MIT-STARLab/PorTeL-Beacon/PorTeL_beacon_board.pdf

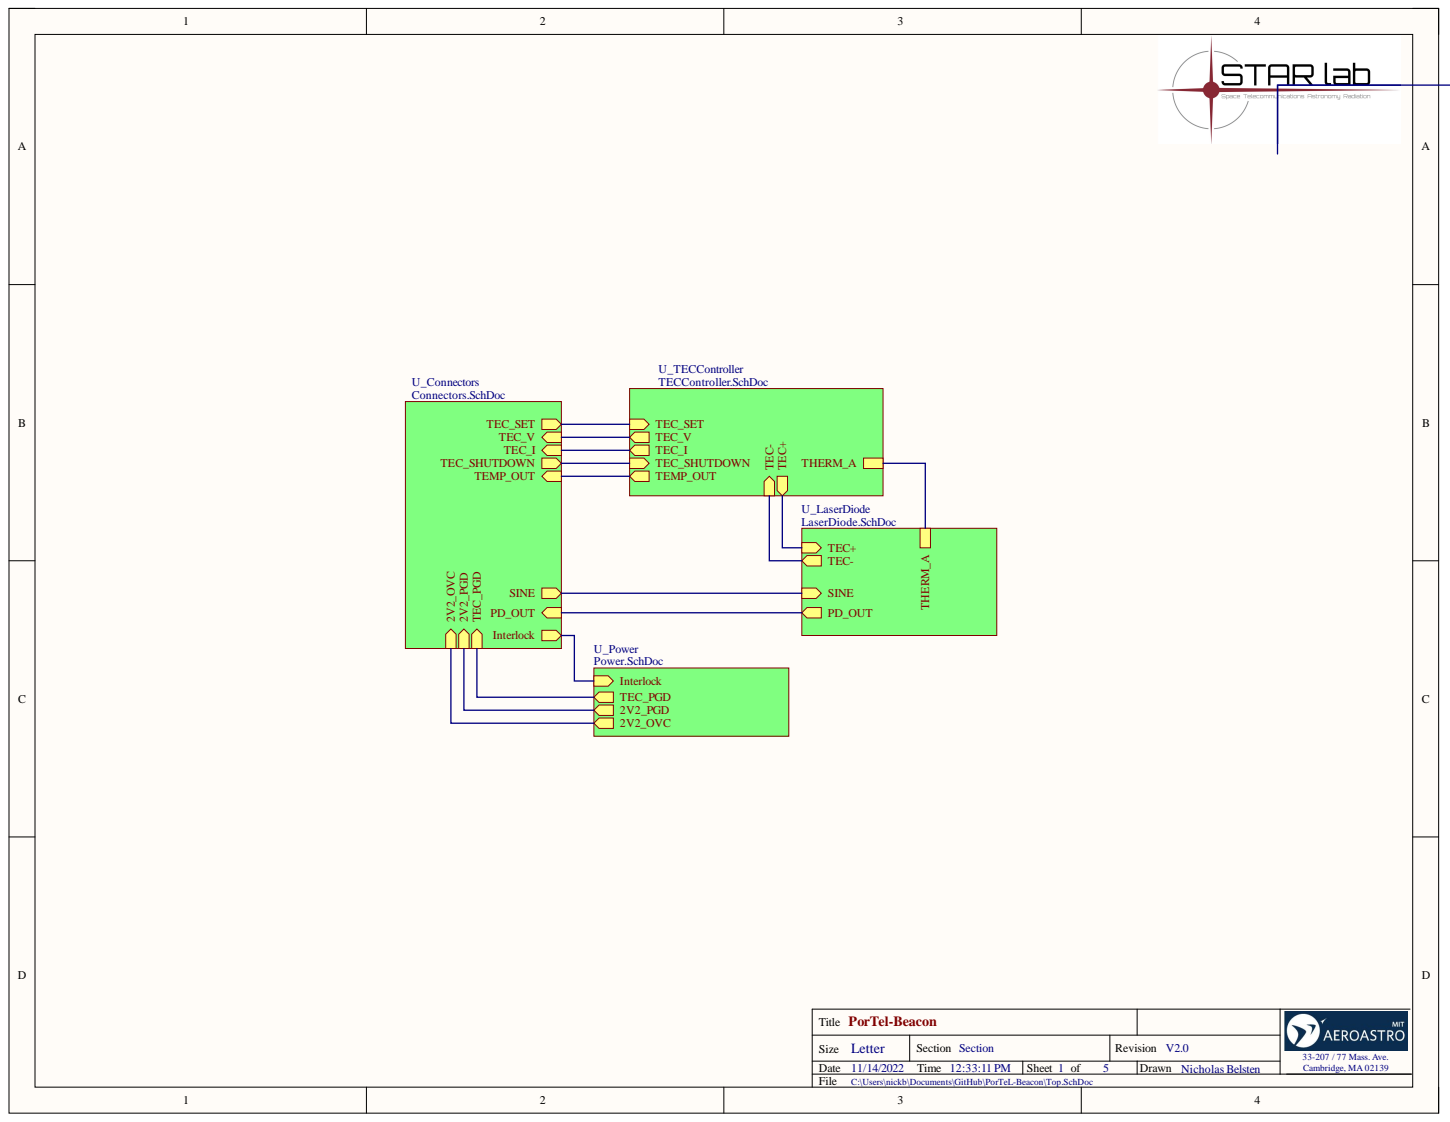
[picture p1: page 1]

C:\Users\nickb\Documents\GitHub\PorTeL-Beacon\Top.SchDoc

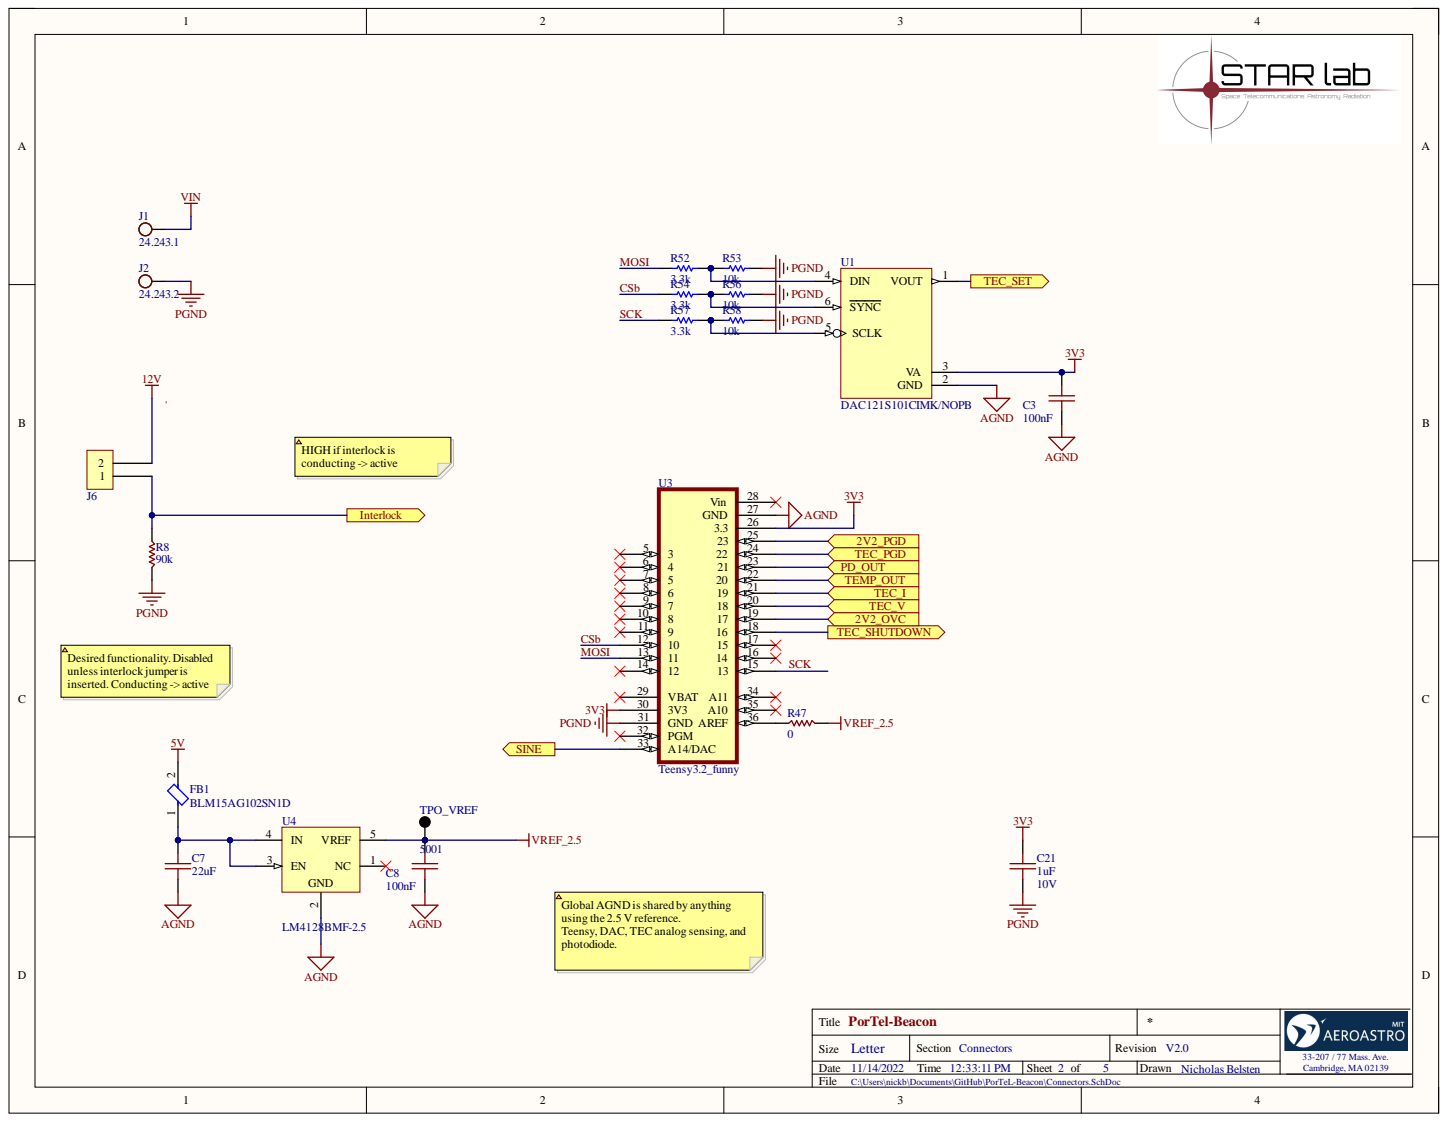
[picture p2: page 2]

HIGH if interlock is
conducting -> active

Global AGND isshared by anything
using the 2.5 V reference.
Teensy, DAC, TEC analog sensing, and
photodiode.

C:\Users\nickb\Documents\GitHub\PorTeL-Beacon\Connectors.SchDoc

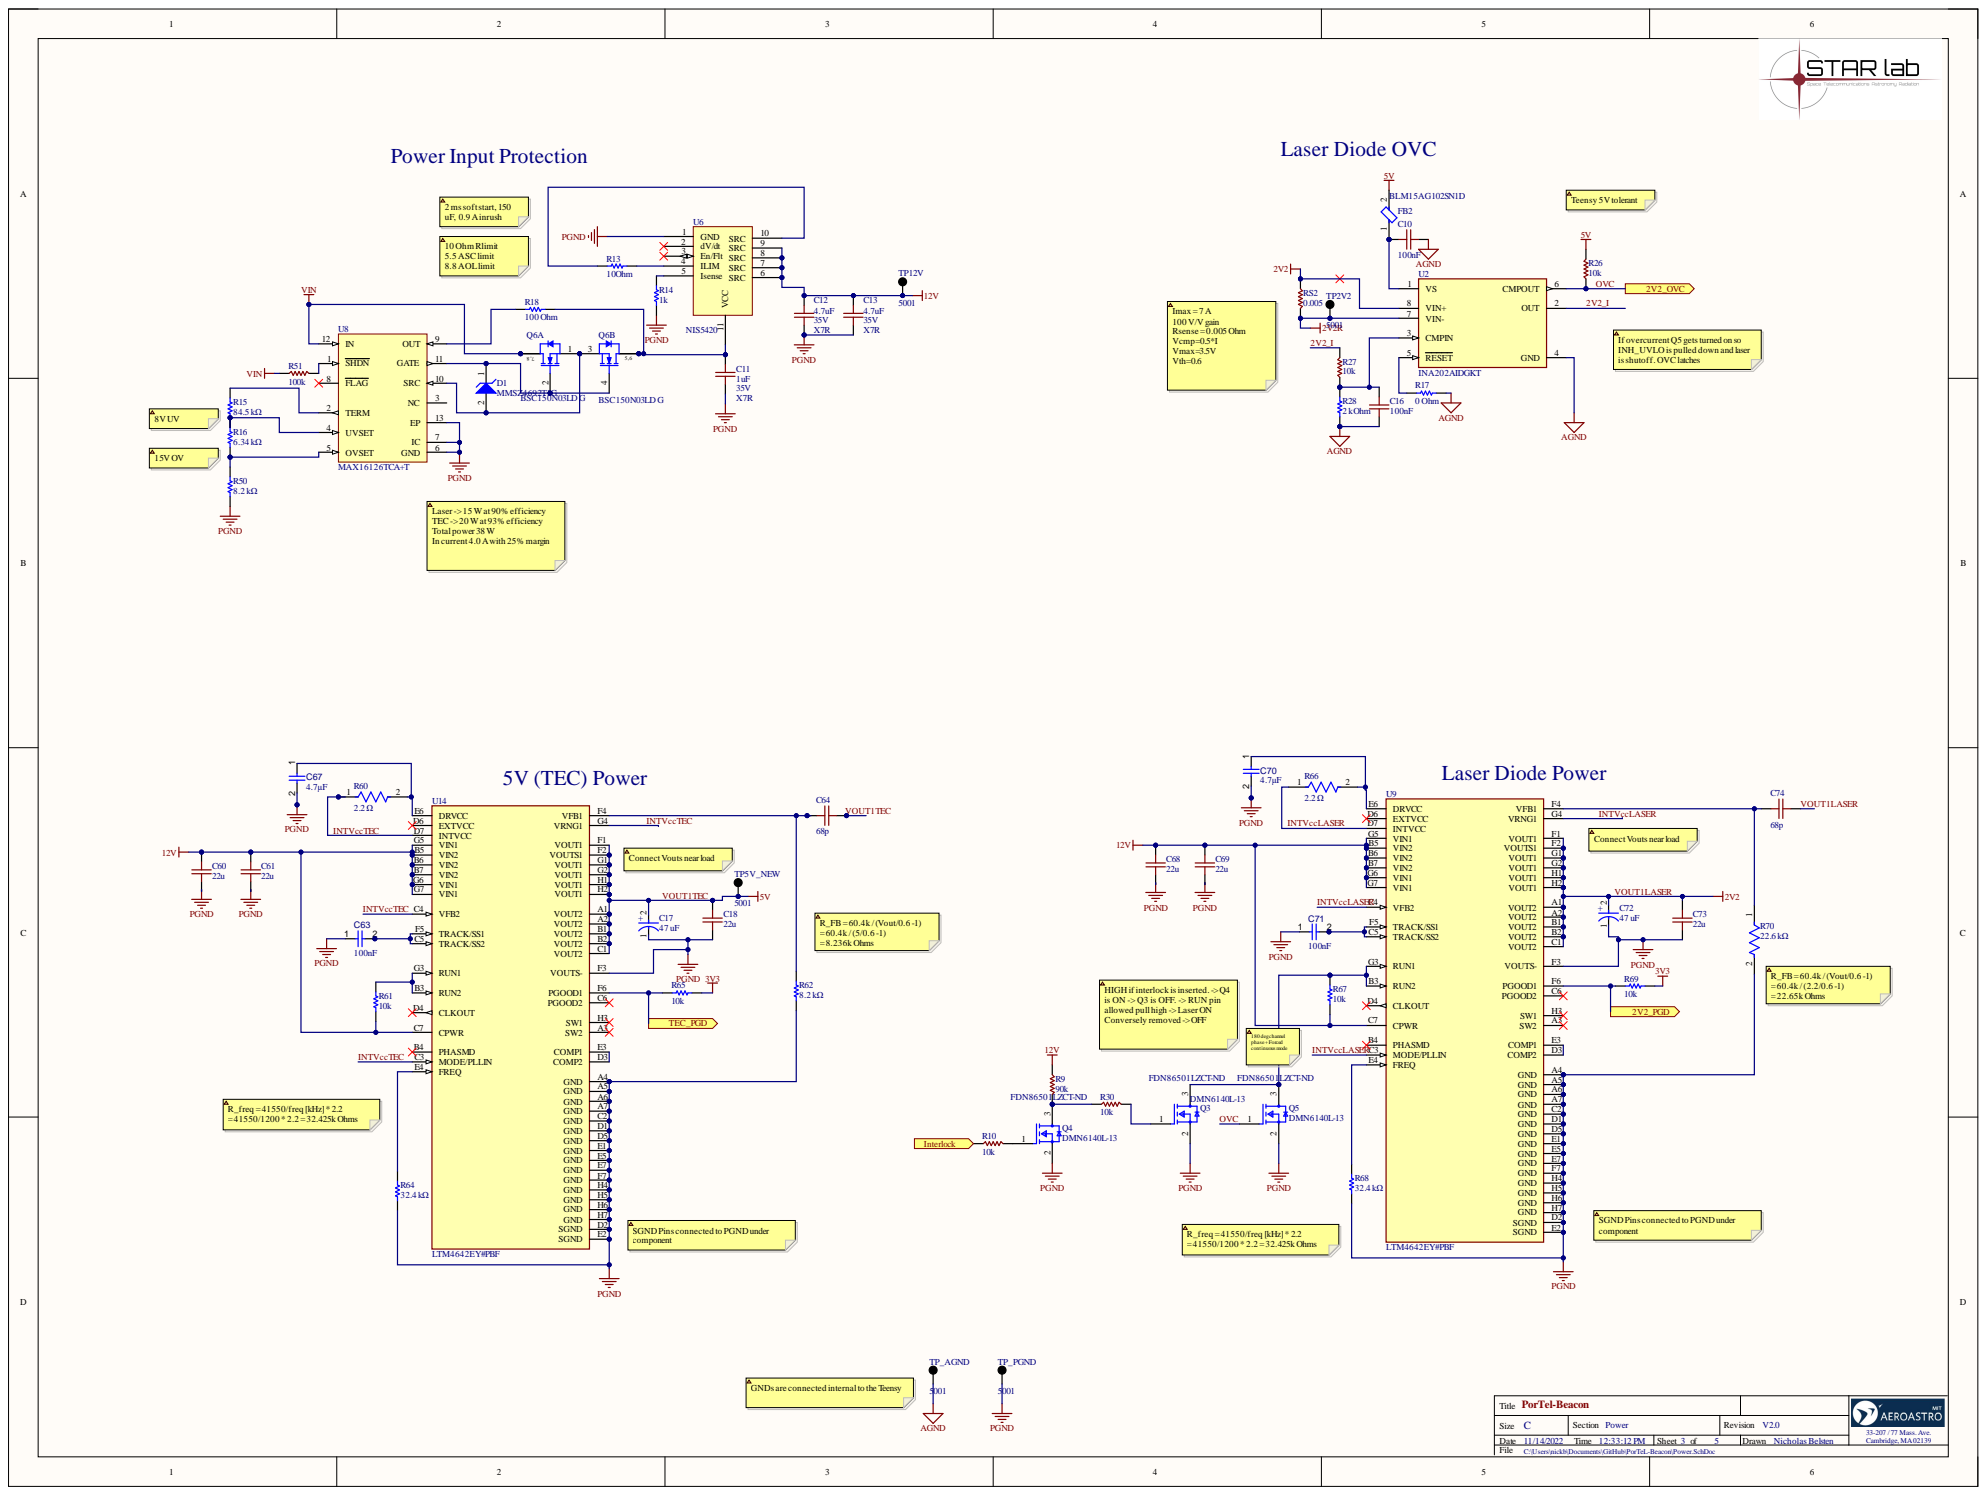
[picture p3: page 3]

If overcurrentQ5 getsturned on so
INH_UVLO is pulled down and laser
isshutoff. OVC latches

R15 84.5 kΩ | | BSC150N03LD G

UVSET 4

HIGH if interlock isinserted.->Q4
is ON -> Q3 is OFF. -> RUN pin
allowed pullhigh ->Laser ON
Conversely removed ->OFF

SGND Pins connected to PGND under
component

GNDs are connected internalto the Teensy

PorTel-Beacon
Title
C:\Users\nickb\Documents\GitHub\PorTeL-Beacon\Power.SchDoc

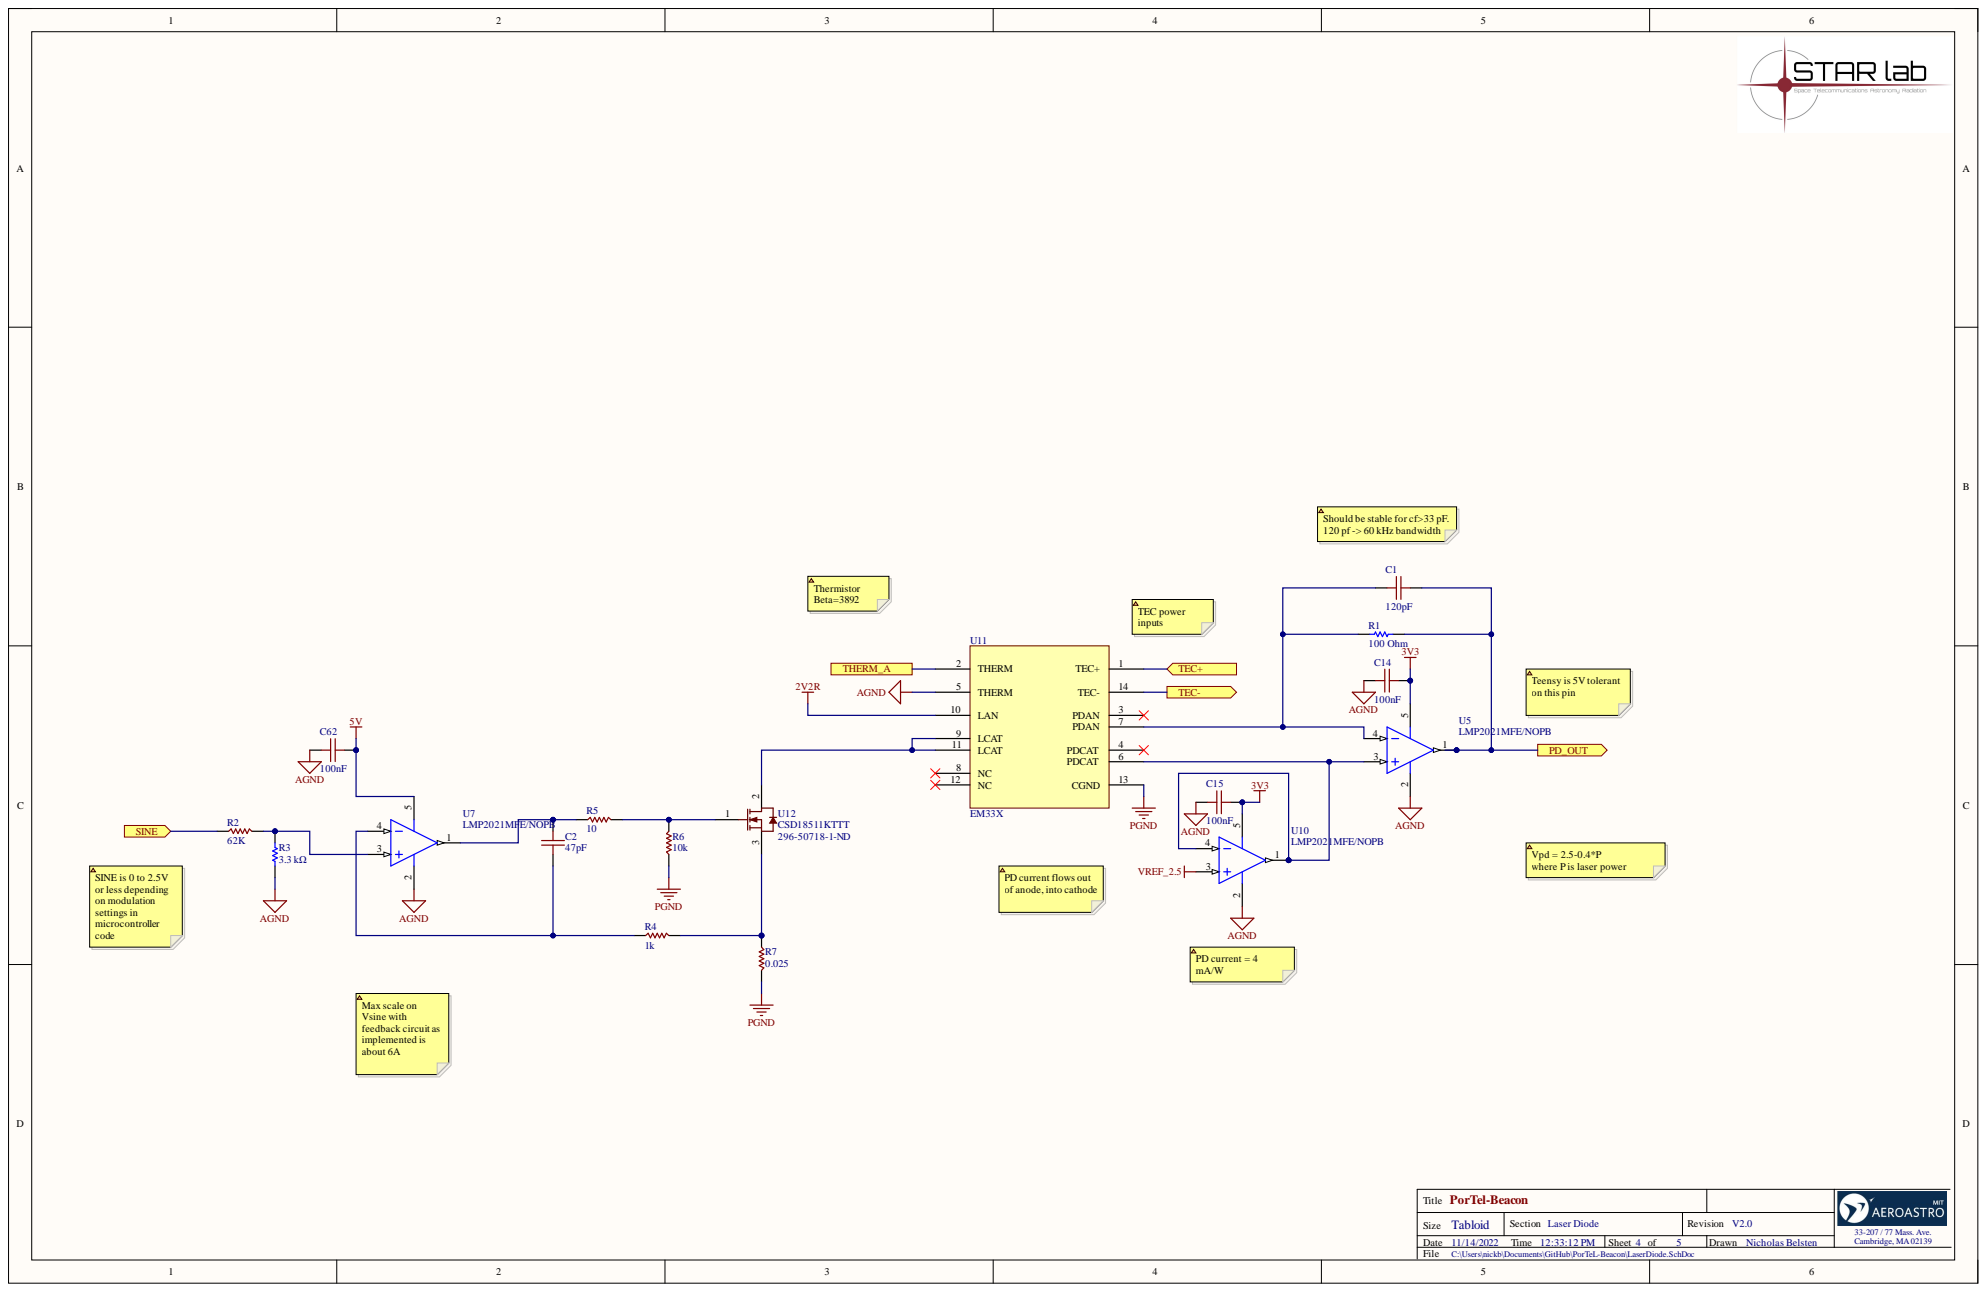
[picture p4: page 4]

U 1 0 LMP 2 0 2

Po r Tel-Be a co n Ti t l e | | 33-207 / 77 M a s s . Ave . C ambridge , M A02139

s\nickb\Documents\GitHub\Por

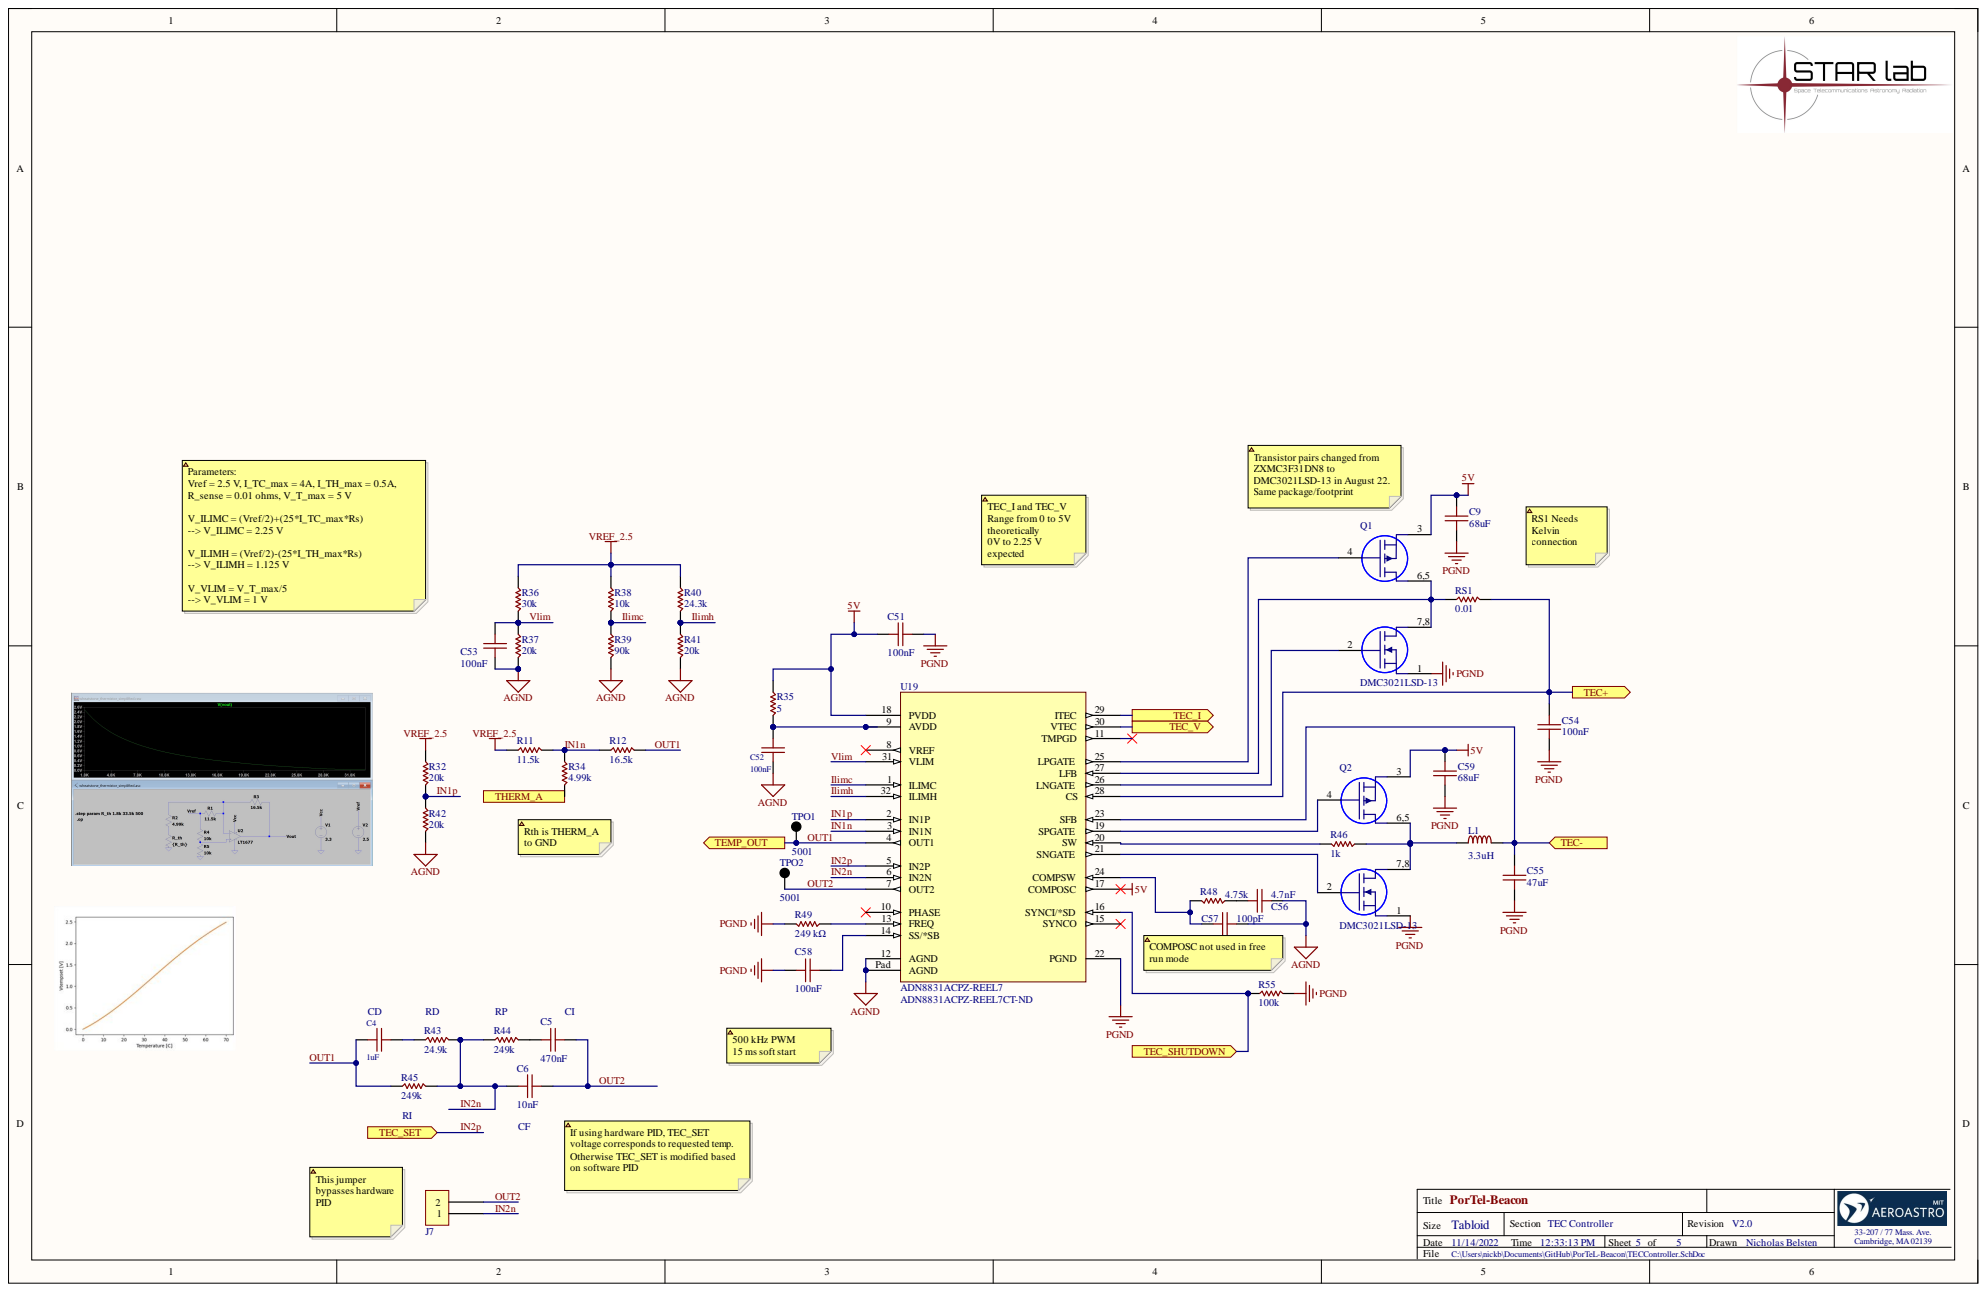
[picture p5: page 5]

Transistor pairs changed from
ZXMC3F31DN8 to
DMC3021LSD-13 in August 22.
Same package/footprint

COMPOSC not used in free
run mode

If using hardware PID, TEC_SET
voltage corresponds to requested temp.
Otherwise TEC_SET is modified based
on software PID

Size Tabloid | Section TEC Controller | Revision V2.0

Date 11/14/2022 Time 12:33:13 PM | Sheet 5 of 5 | Drawn Nicholas Belsten

C:\Users\nickb\Documents\GitHub\PorTeL-Beacon\TECController.SchDoc

Line # | Name | Description | Designator | Quantity | Procurement Instructions | Special Note | Manufacturer 1 | Manufacturer Part Number 1 | Manufacturer Lifecycle 1 | Supplier 1 | Supplier Part Number 1 | Supplier Unit Price 1 | Supplier Subtotal 1
| 68p | 805 Capacitor | C64, C74 | 2
| SIL02 | 2.54mm Header 1x2 | J6, J7 | 2 Turnkey | | | TE Connectivity | 5-146274-2 | Volume Production | Arrow Electronics | 5-146274-2 | 0.3174 | 0.6348
| 5001 | Test Point, Black, 1-Pin THD, RoHS, Bulk | TP2V2, TP5V_NEW, TP12V, TP_AGND, TP_PGND, TPO1, TPO2, TPO_VREF | 8 Turnkey | | | Keystone Electronics | 5001 | Volume Production | Future Electronics | 6273627 | 0.199 | 1.59
| 100pF | 603 Capacitor | C57 | 1 | Turnkey | | Kyocera AVX | 06033C101KAT2A | Volume Production | Digi-Key | 478-7899-1-ND | 0.21 | 0.21
| 10nF | 603 Capacitor | C6 | 1 | Turnkey | | Kyocera AVX | 06035C103KAT2A | Volume Production | Newark | 88W4176 | 0.005 | 0.005
| ADN8831ACPZ-REEL7 | A High Efficiency TEC Controller Solution | U19 | 1 | Consignment | No Overage Available! | Analog Devices | ADN8831ACPZ-REEL7 | Volume Production | Digi-Key | ADN8831ACPZ-REEL7CT-ND
| BLM15AG102SN1D | FERRITE BEAD 1 KOHM 0402 1LN | FB1, FB2 | 2 Turnkey | | | Murata | BLM15AG102SN1D | Volume Production | Digi-Key | 490-1007-1-ND | 0.1 | 0.2
| BSC150N03LD G | N-Channel OptiMOS 3 Power-Transistor, 30 V VDS, 20 A ID, -55 to 150 degC, PG-TDSON-8-4, Reel, Green | Q6 | 1 | Turnkey | | Infineon | BSC150N03LDG | Volume Production | Arrow Electronics | BSC150N03LDGATMA1 | 1.17 | 1.17
| Capacitor 0.1 uF +/- 5% 16 V 0402 | Chip Capacitor, 0.1 uF, +/- 5%, 16 V, 0402 (1005 Metric) | C63, C71 | 2 Turnkey | | | KEMET | C0402C104J4RACTU | Volume Production
| 1uF | 603 Capacitor | C21 | 1 | Turnkey | | KEMET | C0603C105K3PACTU | Volume Production | Avnet | 93K5996 | 0.029 | 0.029
| 120pF | 603 Capacitor | C1 | 1 | Turnkey | | KEMET | C0603C121J5GACTU | Volume Production | Newark | 64K2841 | 0.004 | 0.004
| 47pF | 603 Capacitor | C2 | 1 | Turnkey | | KEMET | C0603C470J3GACTU | Volume Production | Arrow Electronics | C0603C470J3GACTU | 0.0142 | 0.0142
| 4.7nF | 603 Capacitor | C56 | 1 | Turnkey | | KEMET | C0603C472J5GACTU | Volume Production | Newark | 05AC7998 | 0.087 | 0.087
| 470nF | 603 Capacitor | C5 | 1 | Turnkey | | KEMET | C0603C474K4RACTU | Volume Production | Newark | 12AC0600 | 0.126 | 0.126
| 4.7uF | 805 Capacitor | C12, C13 | 2 Turnkey | | | KEMET | C0805C475K3PACTU | Volume Production | Newark | 36X2755 | 0.072 | 0.144
| Capacitor 4.7µF +/-40% 25V 0805 | Chip Capacitor, 4.7µF +/-40%, 25V, 0805, Thickness 1.45 mm | C67, C70 | 2 Turnkey | | | KEMET | C0805C475M3PAC | Volume Production
| 68uF | 1206 Capacitor | C9, C59 | 2 Turnkey | | | TDK | C3216X5R1A686M160AC | Volume Production | Future Electronics | 2103583 | 1.07 | 2.14
| 100nF | 603 Capacitor | C3, C8, C10, C14, C15, C16, C51, C52, C53, C54, C58, C62 | 12 Turnkey | | | Yageo | CC0603KRX7R8BB104 | Volume Production | Newark | 65R8226 | 0.012 | 0.144
| 100k | 603 Resistor | R51, R55 | 2 Turnkey | | | TE Connectivity | CPF0603B100KE1 | Volume Production | Newark | 06AC1302 | 0.13 | 0.26
| CRCW06032R20FKEAHP | RES Thick Film, 2.2Ω, 1%, 0.33W, 100ppm/°C, 0603 | R60, R66 | 2 Turnkey | | | Vishay Dale | CRCW06032R20FKEAHP | Volume Production | Mouser | 71-CRCW06032R20FKEAH | 0.3 | 0.6
| 4.99k | 603 Resistor | R34 | 1 | Turnkey | | Vishay | CRCW06034K99FKEA | Volume Production | Newark | 24W2956 | 0.006 | 0.006
| CRCW06038K20FKEA | | R50, R62 | 2 Turnkey | | | Vishay | CRCW06038K20FKEA | Volume Production | Digi-Key | 541-8.20KHCT-ND | 0.1 | 0.2
| 11.5k | 603 Resistor | R11 | 1 | Turnkey | | Vishay | CRCW060311K5FKEA | Volume Production | Newark | 52K8087 | 0.125 | 0.125
| 20k | 603 Resistor | R32, R41, R42 | 3 Turnkey | | | Vishay | CRCW060320K0FKEA | Volume Production | Newark | 24W2769 | 0.005 | 0.015
| 20k | 603 Resistor | R37 | 1 | Turnkey | | Vishay | CRCW060320K0FKEA | Volume Production | Newark | 24W2769 | 0.005 | 0.005
| 30k | 603 Resistor | R36 | 1 | Turnkey | | Vishay | CRCW060330K0FKEA | Volume Production | Newark | 61M5379 | 0.048 | 0.48
| CRCW060332K4FKEA | | R64, R68 | 2 Turnkey | | | Vishay | CRCW060332K4FKEA | Volume Production | Newark | 25AC7460 | 0.005 | 0.01
| CRCW060384K5FKEA | | R15 | 1 | Turnkey | | Vishay | CRCW060384K5FKEA | Volume Production | Digi-Key | 541-84.5KHCT-ND | 0.1 | 0.1
| 249k | 603 Resistor | R44, R45 | 2 Turnkey | | | Vishay | CRCW0603249KFKEA | Volume Production | Newark | 24W2815 | 0.005 | 0.01
| CSD18511KTTT | 40-V, N channel NexFET™ power MOSFET, single D2PAK, 2.6 mOhm | U12 | 1 | Turnkey | | Texas Instruments | CSD18511KTTT | Unknown | Digi-Key | 296-47449-1-ND | 2.11 | 2.11
| DAC121S101CIMK/NOPB | 12-Bit Micro Power, RRO Digital-to-Analog Converter, 6-pin Tiny SOT23, Pb-Free | U1 | 1 | Turnkey | | TI National Semiconductor | DAC121S101CIMK/NOPB | Volume Production | Mouser | 926-DAC121S101CIMKNO | 2.94 | 2.94
| Teensy3.2_funny | | U3 | 1 | DNP | | SparkFun | DEV-13736 | Unknown
| FDS8960C | Trans Mosfet N/p-ch 30V 8.5A/7A 8-PIN SOIC T/r | Q1, Q2 | 2 Turnkey | | | Diodes | DMC3021LSD-13 | Volume Production | Arrow Electronics | DMC3021LSD-13 | 0.2144 | 536
| EM33X | 5W Cooled 9XX Multimode Lasers in 14-Pin Package | U11 | 1 | DNP | | Gooch and Housego | EM33X | Manual Solution
| 1k | 603 Resistor | R46 | 1 | Turnkey | | Panasonic | ERA-3AEB103V | Volume Production | RSComponent s | 566890 | 0.67133 | 3.36
| 10k | 603 Resistor | R10, R26, R30 | 3 Turnkey | | | Panasonic | ERA-3AEB103V | Volume Production | RSComponent s | 566890 | 0.67133 | 3.36
| 10k | 603 Resistor | R38 | 1 | Turnkey | | Panasonic | ERA-3AEB103V | Volume Production | RSComponent s | 566890 | 0.67133 | 3.36
| ERJ-3EKF1000V | | R1, R18 | 2 Turnkey | | | Panasonic | ERJ3EKF1000V | Volume Production | Newark | 90W3098 | 0.007 | 0.014
| ERA3AEB102V | | R14, R61, R65, R67, R69 | 5 Turnkey | | | Panasonic | ERJ3EKF1001V | Volume Production | Newark | 25AC9114 | 0.007 | 0.035
| 16.5k | 603 Resistor | R12 | 1 | Turnkey | | Panasonic | ERJ3EKF1652V | Volume Production | Digi-Key | P16.5KHDKR-ND | 0.1 | 0.1
| ERJ6ENF3301V | | R3 | 1 | Turnkey | | Panasonic | ERJ6ENF3301V | Volume Production | Avnet | 64R5400 | 0.019 | 0.019
| ERJ-2GEJ103X | | R53, R56, R58 | 3 Turnkey | | | Panasonic | ERJ-2GEJ103X | Volume Production | Newark | 12AC0920 | 0.004 | 0.012
| ERJ-3EKF2001V | | R28 | 1 | Turnkey | | Panasonic | ERJ-3EKF2001V | Volume Production | Newark | 12AC1028 | 0.006 | 0.006
| 24.3k | 603 Resistor | R40 | 1 | Turnkey | | Panasonic | ERJ-3EKF2432V | Volume Production | Allied Electronics | 70265735 | 0.016 | 0.016
| 24.9k | 603 Resistor | R43 | 1 | Turnkey | | Panasonic | ERJ-3EKF2492V | Volume Production | Mouser | 667-ERJ-3EKF2492V | 0.1 | 0.1
| ERJ-3EKF6341V | | R16 | 1 | Turnkey | | Panasonic | ERJ-3EKF6341V | Volume Production | Newark | 65T8502 | 0.004 | 0.004
| 0.01 | 1206 Resistor | RS1 | 1 | Turnkey | | Panasonic | ERJ-8BWFR010V | Volume Production | Digi-Key | P.010AUCT-ND | 0.84 | 0.84
| 0.025 | 1206 Resistor | R7 | 1 | Turnkey | | Panasonic | ERJ-8CWFR025V | Volume Production | Newark | 52W0479 | 0.121 | 0.121
| DMN6140L-13 | MOSFET N-CH 60V 1.6A SOT23 | Q3, Q4, Q5 | 3 Turnkey | | | ON Semiconductor / Fairchild | FDN86501LZ | Volume Production | Arrow Electronics | FDN86501LZ | 2.15 | 6.44
| 22u | 1210 Capacitor | C18, C60, C61, C68, C69, C73 | 6 | | | Murata | GRM32ER61E226KE15L | Unknown | Future Electronics | 5237714 | 0.56 | 3.36
| 22uF | 1210 Capacitor | C7 | 1 | Turnkey | | Murata | GRM32ER61E226KE15L | Unknown | Future Electronics | 5237714 | 0.56 | 0.56
| 1uF | 805 Capacitor | C11 | 1 | Turnkey | | Murata | GRM216R61E105KA12D | Unknown | Future Electronics | 7699986 | 0.32 | 0.32
| 47uF | 805 Capacitor | C55 | 1 | Turnkey | | Murata | GRT21BR60J476ME13L | Volume Production | Future Electronics | 1104112 | 0.415 | 0.415
| INA201AIDGKR | IC CURRENT MONITOR 3.5% 8VSSOP | U2 | 1 | Turnkey | | Texas Instruments | INA202AIDGKT | Volume Production | Mouser | 595-INA202AIDGKT | 3.49 | 3.49
| LM4128BMF-2.5 | Precision Micropower Series Voltage Reference, 5-pin SOT-23 | U4 | 1 | Turnkey | | TI National Semiconductor | LM4128DQ1MF2.5/NOPB | Volume Production | Digi-Key | 296-LM4128DQ1MF2.5/NOPB CT-ND | 3.12 | 3.12
| LMP2021MFE/NOPB | Zero Drift, Low Noise, EMI Hardened Amplifier, 5-pin SOT-23, Pb-Free | U5, U7, U10 | 3 Turnkey | | | TI National Semiconductor | LMP2021MFE/NOPB | Volume Production | Arrow Electronics | LMP2021MFE/NOPB | 3.69 | 11.07
| LTM4642EY#PBF | DC DC CNVRTR 0.6-5.5V 0.6-5.5V | U9, U14 | 2 Turnkey | | | Analog Devices / Linear Technology | LTM4642EY#PBF | Volume Production | Digi-Key | 505-LTM4642EY#PBF-ND | 30.6 | 61.2
| MAX16126TCA+T | Load-Dump/Reverse-Voltage Protection Circuit, switch-mode fault management, 12-Pin TQFN-EP, -40°C to +125°C, Pb-Free, Tape and Reel | U8 | 1 | Turnkey | | Maxim | MAX16126TCA+T | Volume Production | Newark | 38AC1459 | 2.78 | 2.78
| MMSZ4692T1G | Zener Voltage Regulator, 500 mW, 2-Pin SOD-123, Pb-Free, Tape and Reel | D1 | 1 | Turnkey | | ON Semiconductor | MMSZ4692T1G | Volume Production | Digi-Key | MMSZ4692T1GOSCT-ND | 0.25 | 0.25
| NIS5420 | | U6 | 1 | Turnkey | | ON Semiconductor | NIS5420MT6TXG | Unknown | Arrow Electronics | NIS5420MT6TXG | 1.8 | 1.8
| RC0402FR-073K3L | | R52, R54, R57 | 3 Turnkey | | | Yageo | RC0402FR-073K3L | Volume Production | Mouser | 603-RC0402FR-073K3L | 0.014 | 0.14
| CRCW040222K6FKED | RES Thick Film, 22.6kΩ, 1%, 0.063W, 100ppm/°C, 0402 | R70 | 1 | Turnkey | | Yageo | RC0402FR-0722K6L | Volume Production | Digi-Key | YAG3061CT-ND | 0.1 | 0.1
| RC0603FR-0710RL | Chip Resistor, 10 Ohm, +/- 1%, 0.1 W, -55 to 155 degC, 0603 (1608 Metric), RoHS, Tape and Reel | R13 | 1 | Turnkey | | Yageo | RC0603FR-0710RL | Volume Production | Avnet | 98K7348 | 0.042 | 0.042
| 90k | 603 Resistor | R8, R9, R39 | 3 Turnkey | | | Yageo | RC0603FR-07390KL | Volume Production | Digi-Key | 311-390KHRCT-ND | 0.021 | 0.21
| 0 | 603 Resistor | R47 | 1 | Turnkey | | Yageo | RC0603JR-070RL | Volume Production | Newark | 68R0136 | 0.065 | 0.065
| 10k | 805 Resistor | R6, R27 | 2 Turnkey | | | Yageo | RC0805FR-0710KL | Volume Production | Newark | 85X1799 | 0.004 | 0.008
| 1k | 805 Resistor | R4 | 1 | Turnkey | | Susumu | RG2012P-102-B-T5 | Volume Production | Future Electronics | 2000243 | 0.29 | 0.29
| 5 | 805 Resistor | R35 | 1 | Turnkey | | Cyntec | RLT1220-F-5R00-FNH | Unknown | Digi-Key | 2037-RLT1220-F-5R00-FNHCT-ND | 0.53 | 0.53
| 10 | 805 Resistor | R5 | 1 | Turnkey | | Stackpole Electronics | RNCF0805AKT10R0 | Volume Production | Arrow Electronics | RNCF0805AKT10R0 | 0.9458 | 0.9458
| 62K | 805 Resistor | R2 | 1 | Turnkey | | Susumu | RR1220P-623-D | Volume Production | Digi-Key | RR12P62.0KDCT-ND | 0.16 | 0.16
| 4.75k | 603 Resistor | R48 | 1 | Turnkey | | Yageo | RT0603BRD074K75L | Volume Production | Arrow Electronics | RT0603BRD074K75L | 0.2882 | 0.2882
| 3.3uH | Bourns SRP0520 3.3uH 4.8A Inductor | L1 | 1 | Turnkey | | Bourns | SRP0520-3R3K | Unknown | Arrow Electronics | SRP0520-3R3K | 0.4583 | 0.4583
| T491D476K025AT | CAP TANT 47UF 10% 25V 2917 | C17, C72 | 2 | | | KEMET | T491D476K025AT | Volume Production | Newark | 95W0144 | 1.04 | 2.08
| 249 kΩ | 603 Resistor | R49 | 1 | Turnkey | | Vishay Dale | TNPW0603249KBEEA | Volume Production | Arrow Electronics | TNPW0603249KBEEA | 0.5701 | 0.5701
| 1uF | 603 Capacitor | C4 | 1 | Turnkey | | Taiyo Yuden | UMK107BJ105KA-T | Volume Production | Newark | 06X2717 | 0.018 | 0.018
| 0.005 | 1206 Resistor | RS2 | 1 | Turnkey | | Vishay Dale | WSLP12065L000FEA | Volume Production | Digi-Key | WSLP-.005CT-ND | 1.06 | 1.06
