MIT-STARLab/PorTeL-Beacon/(list of files, drawings)

Other design files:
BeaconBoard.SchLib
Connectors.SchDoc
LaserDiode.SchDoc
PorTeL_beacon_board.PrjPcb
Power.SchDoc
PSSL3.SchLib
TECController.SchDoc
Top.SchDoc
