MIT-STARLab/PorTeL-Beacon/(commit log)

2021-10-21 microcontroller interface update and error corrections
    [BeaconBoard.SchLib, Connectors.SchDoc, Control.SchDoc, LaserDiode.SchDoc, PorTeL_beacon_board.PrjPcb, Power.SchDoc, TECController.SchDoc, Top.SchDoc]
2021-10-21 add pdf schematic
2021-11-07 update for different efuse solution
    last one was out of stock. Also, efuses don't work correctly with these low voltage levels
    [BeaconBoard.SchLib, Connectors.SchDoc, LaserDiode.SchDoc, PorTeL_beacon_board.PrjPcb, Power.SchDoc, TECController.SchDoc, Top.SchDoc]
2021-11-07 update top to match efuse update
    [Connectors.SchDoc, Top.SchDoc]
2021-11-12 finish layout for microcontroller version
    Made changes to account for part unavailability too
    [BeaconBoard.SchLib, LaserDiode.SchDoc, PorTeL_beacon_board.PrjPcb, Power.SchDoc, TECController.SchDoc]
2021-11-12 updates to bomdoc
    [Connectors.SchDoc, LaserDiode.SchDoc, Power.SchDoc, TECController.SchDoc]
2022-06-08 notes on bringup testing
    [Connectors.SchDoc, LaserDiode.SchDoc, PorTeL_beacon_board.PrjPcb, Power.SchDoc, TECController.SchDoc]
2022-06-24 update with bringup notes
    [LaserDiode.SchDoc, TECController.SchDoc]
2022-06-24 Update template with project and contact info
    [Connectors.SchDoc, LaserDiode.SchDoc, Power.SchDoc, TECController.SchDoc, Top.SchDoc]
2022-08-30 v2.0 replace out of stock components
    [BeaconBoard.SchLib, Connectors.SchDoc, LaserDiode.SchDoc, PSSL3.SchLib, PorTeL_beacon_board.PrjPcb, Power.SchDoc, TECController.SchDoc, Top.SchDoc]
2022-11-14 Update for component unavailability
    [Connectors.SchDoc, LaserDiode.SchDoc, PorTeL_beacon_board.PrjPcb, Power.SchDoc, TECController.SchDoc]
2022-12-08 Update to V2.1 following board review
    [Connectors.SchDoc, PorTeL_beacon_board.PrjPcb, Power.SchDoc]
2022-12-09 Fix resistor name/comment mismatch for circuithub
    [Connectors.SchDoc, PorTeL_beacon_board.PrjPcb, Power.SchDoc, TECController.SchDoc]
2022-12-09 fix capacitor comment value mismatches
    [Connectors.SchDoc, TECController.SchDoc]
2023-02-23 fab of V2
    [Connectors.SchDoc, LaserDiode.SchDoc, Power.SchDoc, TECController.SchDoc]
